mattlokes/onash2/README.md

# onash2
3D Printed Home/Server NAS based on the ODroid H2+

[Documentation](https://mattlokes.github.io/onash2/)
