mattlokes/onash2/docs/h2plus_pinmap.png

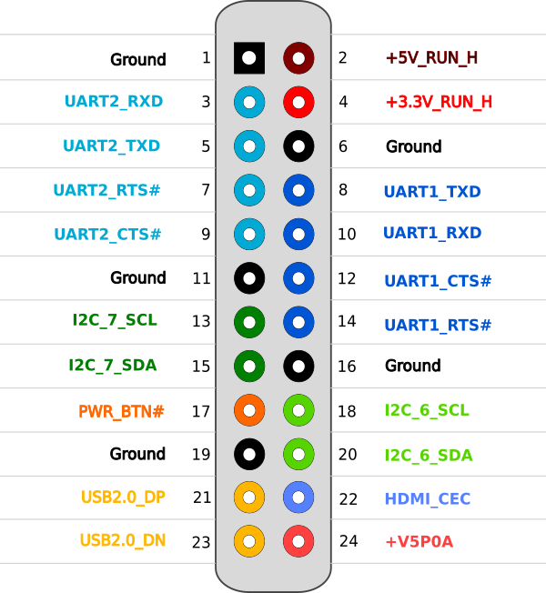
docs/h2plus_pinmap.png
