mattlokes/onash2/docs/i2c_oled.jpg

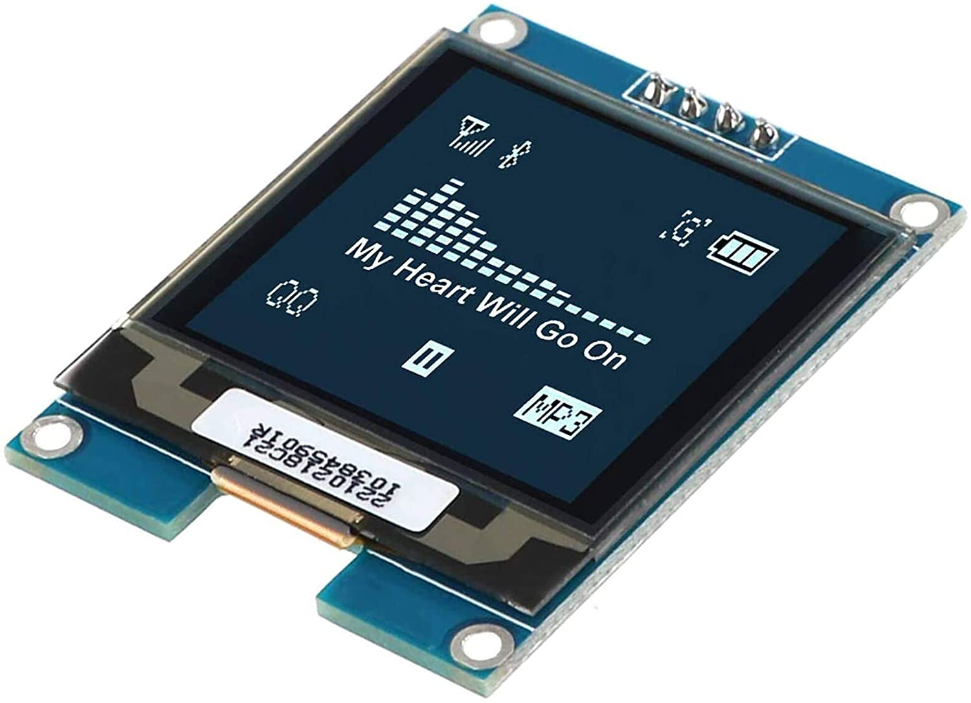
docs/i2c_oled.jpg
