mattlokes/onash2/docs/onash2_hdd_legs.jpg

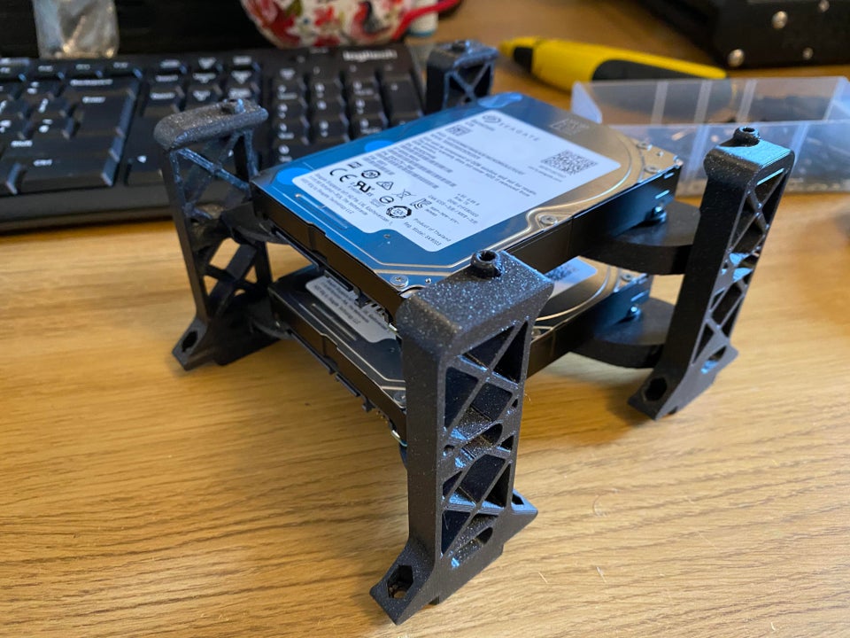
docs/onash2_hdd_legs.jpg
