mattlokes/onash2/docs/onash2_oled.jpg

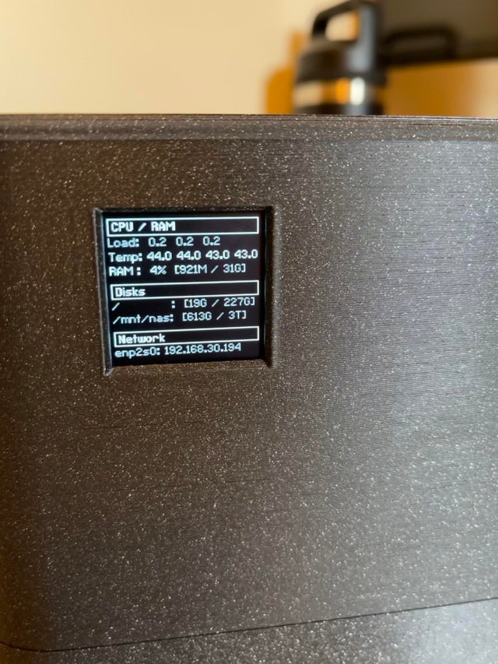
docs/onash2_oled.jpg
