mattlokes/onash2/docs/onash2_open2.jpg

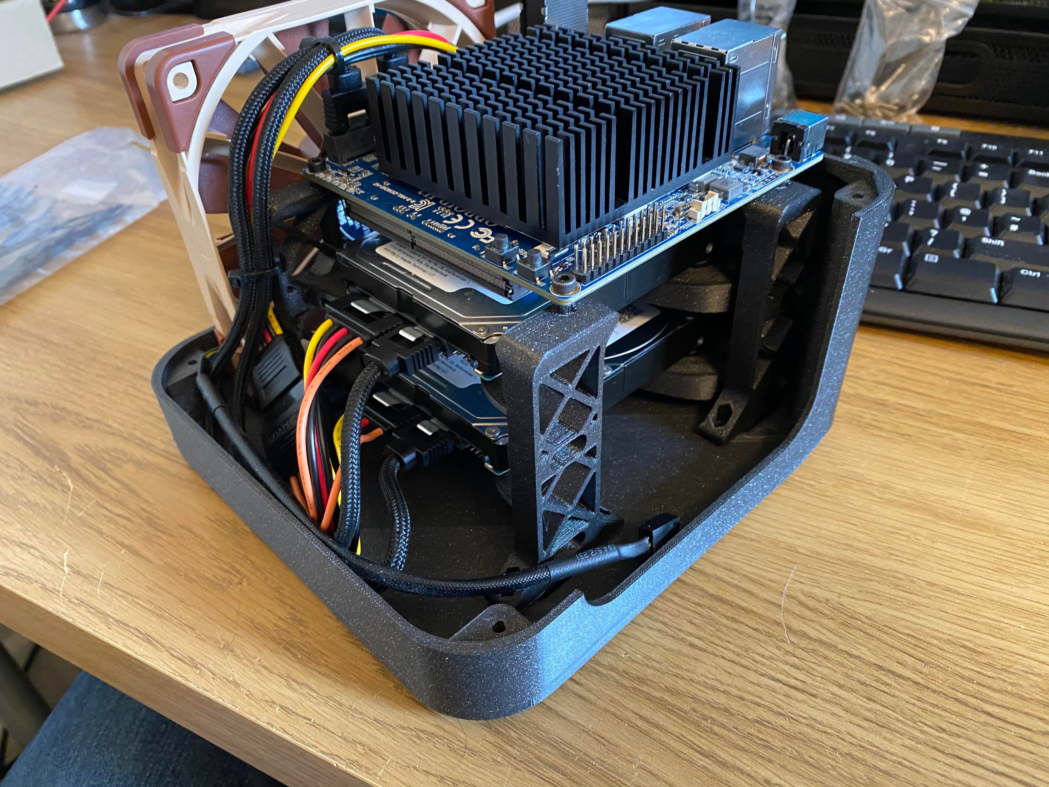
docs/onash2_open2.jpg
