mattlokes/onash2/docs/onash2_open.jpg

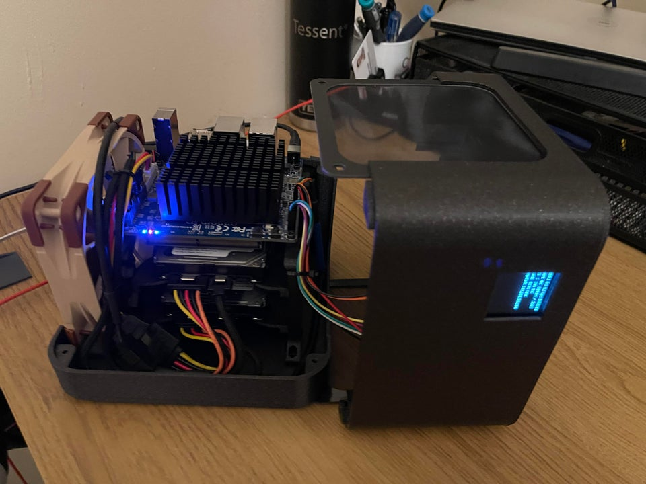
docs/onash2_open.jpg
