mattlokes/onash2/docs/onash2_rear.jpg

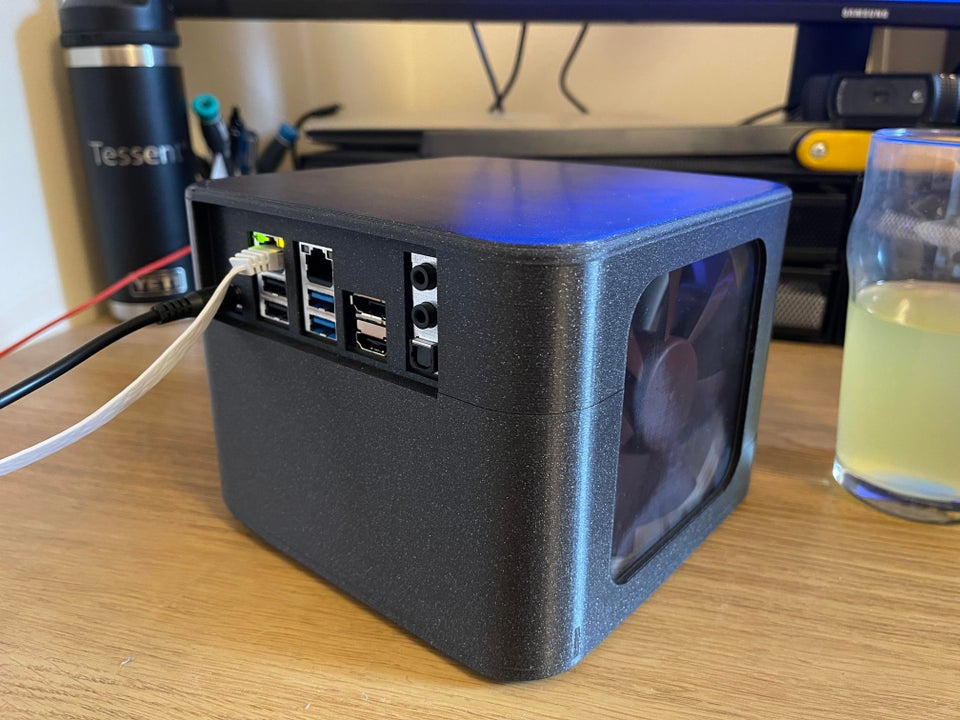
docs/onash2_rear.jpg
