mattlokes/onash2/stl/onash2_leg_1.stl

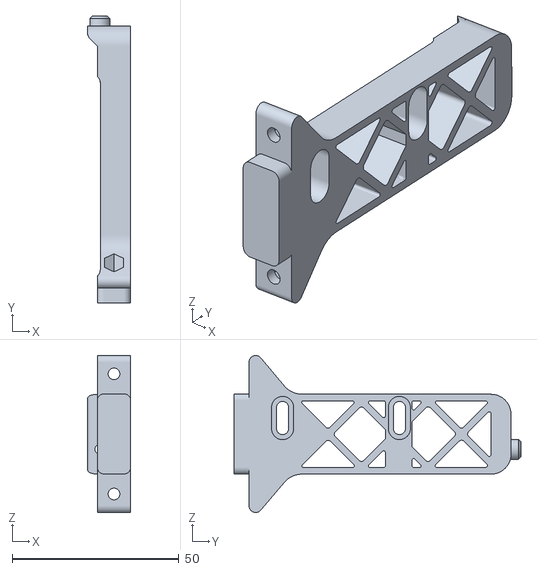
[picture p10: CAD file, 2020-11-17]
stl/onash2_leg_1.stl
13.0 x 86.0 x 47.0
