mattlokes/onash2/stl/onash2_2.5_3.5_hdd_adapter.stl

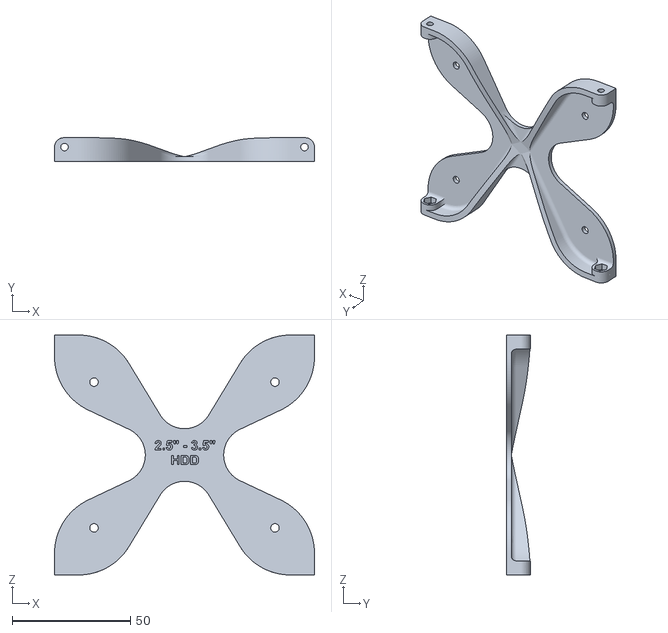
[picture p11: CAD file, 2020-11-17]
stl/onash2_2.5_3.5_hdd_adapter.stl
110.1 x 10.0 x 101.6
