mattlokes/onash2/stl/onash2_case_bottom.stl

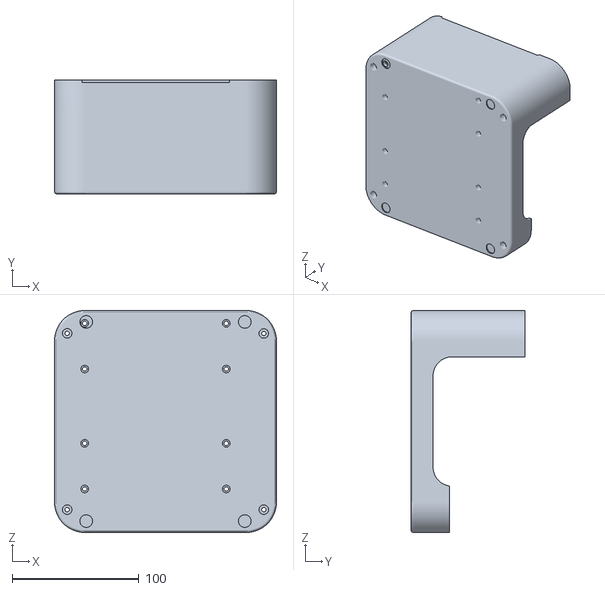
[picture p12: CAD file, 2020-11-17]
stl/onash2_case_bottom.stl
175.0 x 90.0 x 175.0
