mattlokes/onash2/stl/onash2_leg_2.stl

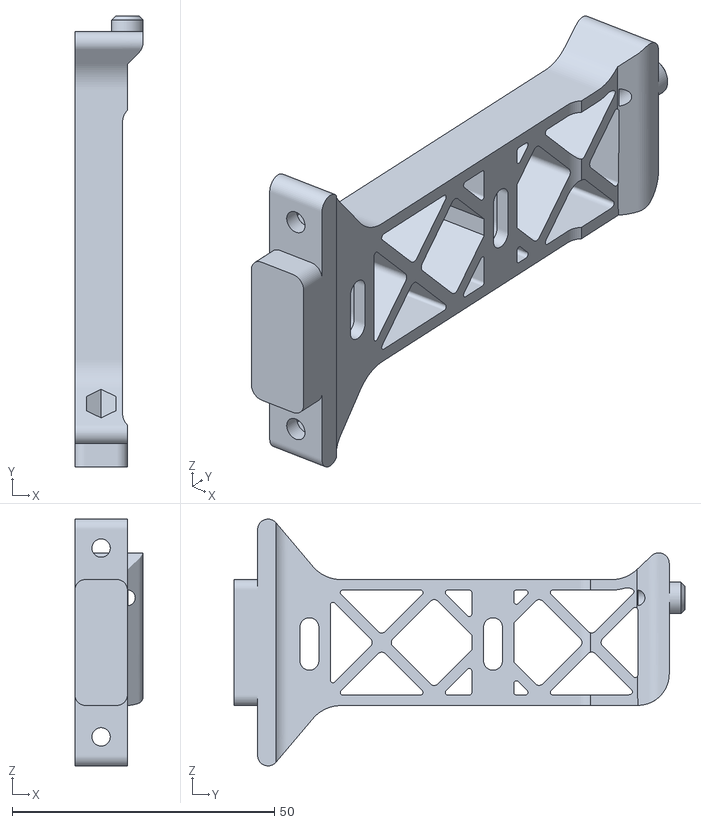
[picture p13: CAD file, 2020-11-17]
stl/onash2_leg_2.stl
13.0 x 86.0 x 47.1
