mattlokes/onash2/stl/onash2_case_top.stl

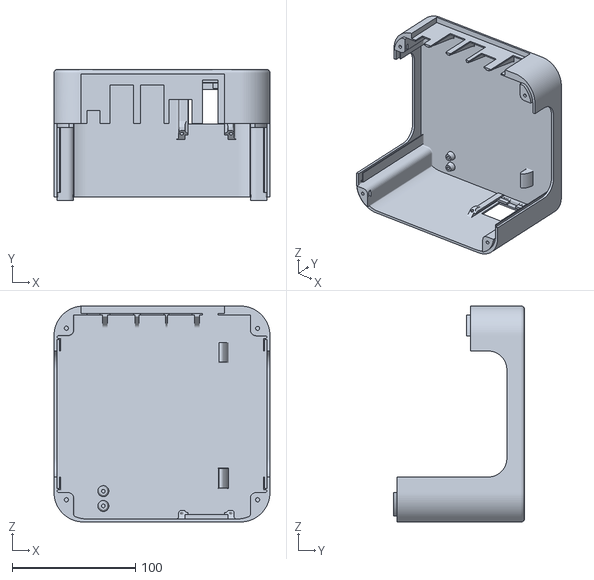
[picture p14: CAD file, 2020-11-17]
stl/onash2_case_top.stl
175.0 x 106.5 x 175.0
