mattlokes/onash2/(list of files, cad)

Other CAD files:
stl/onash2_leg_3.stl
stl/onash2_leg_0.stl
