mattlokes/onash2/(threads)

Thread 1 (2020-12-18):

3.5" HDD and free space

strange-v, 2020-12-18:
Have you tried to put a 3.5” HDD in this case?
It seems that cables (data and power) should be bent really well to fit into available space.

mattlokes, 2020-12-19:
I have, and it really needs right angle SATA power & Data cables.

strange-v, 2020-12-19:
Thanks for the answer. Probably I'll design a bit bigger version to eliminate this requirement.

Closed 2020-12-19.

Thread 2 (2021-01-20):

Weird fan behavior

strange-v, 2021-01-20:
Hi again.

Could you tell me, whether in your case Noctua NF-F12 5V PWM 120mm fan works correctly?
I have the issue, that after the system start, it spins with constant RPM (<400) and doesn't react to temperature changes.

More details here: https://forum.odroid.com/viewtopic.php?f=168&t=41565&p=318992

mattlokes, 2021-01-20:
Hey,

The fan is working fine for me, it remains off until the temperature hits
the threshold and then  it spins up until the temperature drops down again.

I’m not at my computer right right now, but I’ll have a look what I have my
bios settings are and post back 👍🏻

Thanks
Matt

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

strange-v, 2021-01-20:
Thank you, Matt.

It'll be cool if you can execute these commands after the fan starts spinning:
```
# modprobe emc2103
# sensors
```
The last command requires lm-sensors
`#  apt install lm-sensors`

strange-v, 2021-01-22:
Matt, I solved my problem with a DIY adapter, so now it works.

But I'm curious, whether it's a common issue (it should be) or just a single case. So please, execute the commands above when you have time.

Thank you.

mattlokes, 2021-01-22:
My fan so rarely starts up, it’s been difficult catching it. I will when I
can.

How had you previously connected it?

What is your DIY adapter now?

Many Thanks
Matt

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

strange-v, 2021-01-22:
Previously it was connected directly to the board (as it should be if everything is okay).
Now I'm using a small MCU in the middle (fan's tacho output connected to the MCU), the logic is simple:
- if the fan spins, but RPM < 500 - emulate 500 RPM signal
- if the fan's RPM >= 500 - emulate the signal for the actual speed
- if the fan doesn't spin at all - do nothing (no signal)

According to the emc2103 datasheet (our board uses it as a fan controller), it cannot recognize speed below 500 RPM but during the fan startup, emc2103  spins it with 20% speed (around 300 RPM).
