mattlokes/onash2/(commit log)

2020-11-17 Added STLs and Fusion 360 File
    [onash2_2.5_3.5_hdd_adapter.stl, onash2_case_bottom.stl, onash2_case_top.stl, onash2_leg_0.stl, onash2_leg_1.stl, onash2_leg_2.stl, onash2_leg_3.stl]
2020-11-21 add wiring diagram
2020-11-21 Realtek 8125 Ethernet Driver compiled for Kernel version 5.4.0-52
